AryeIs/DMM_Module/DMM_Module.pdf

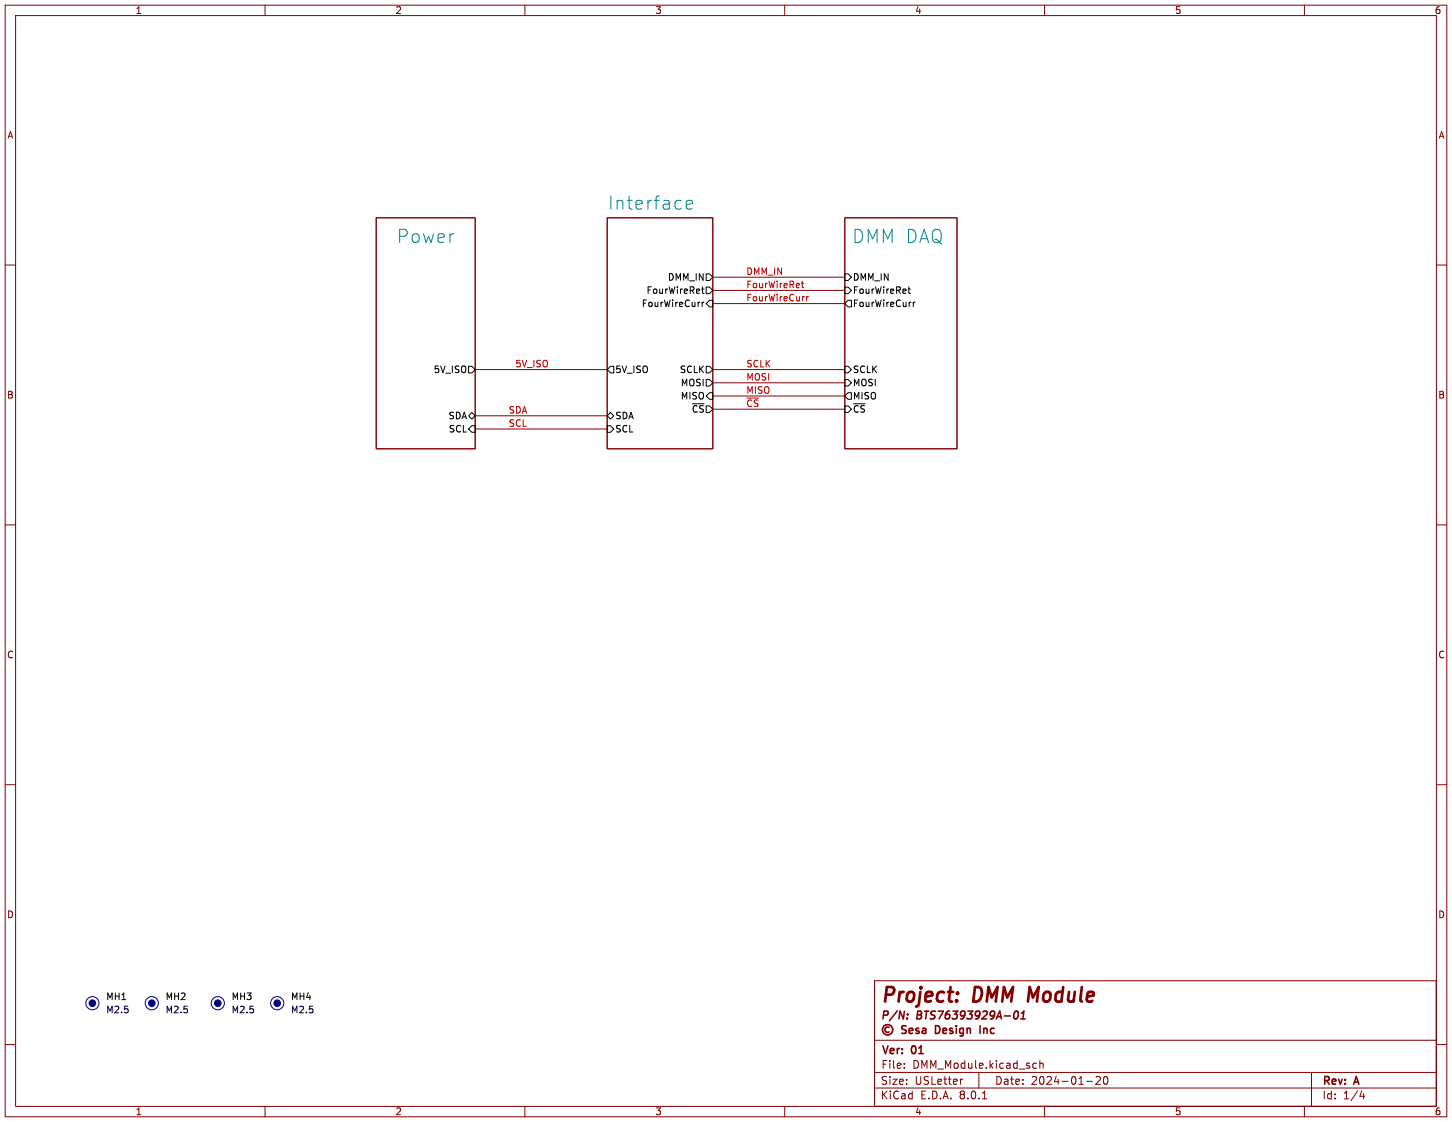
[picture p1: page 1]

SCLK MOSI FourWireRet FourWireCurr DMM_IN DMM DAQ

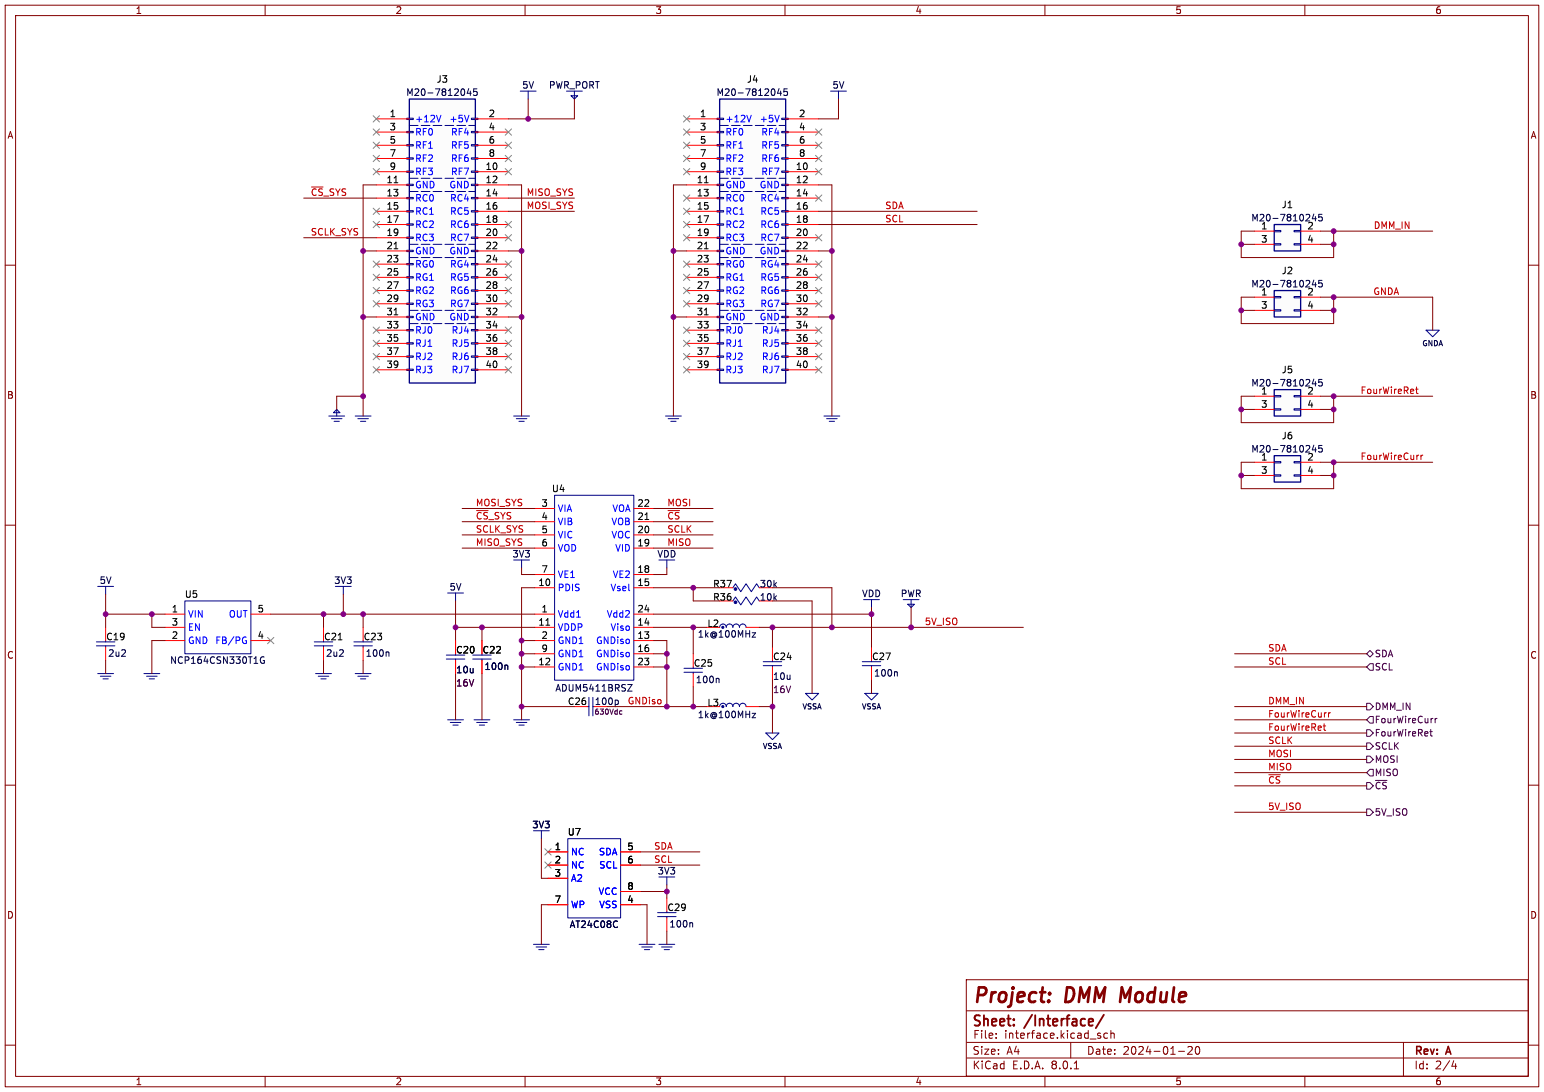
[picture p2: page 2]

~{CS} SDA
FourWireCurr MOSI SCL SCLK

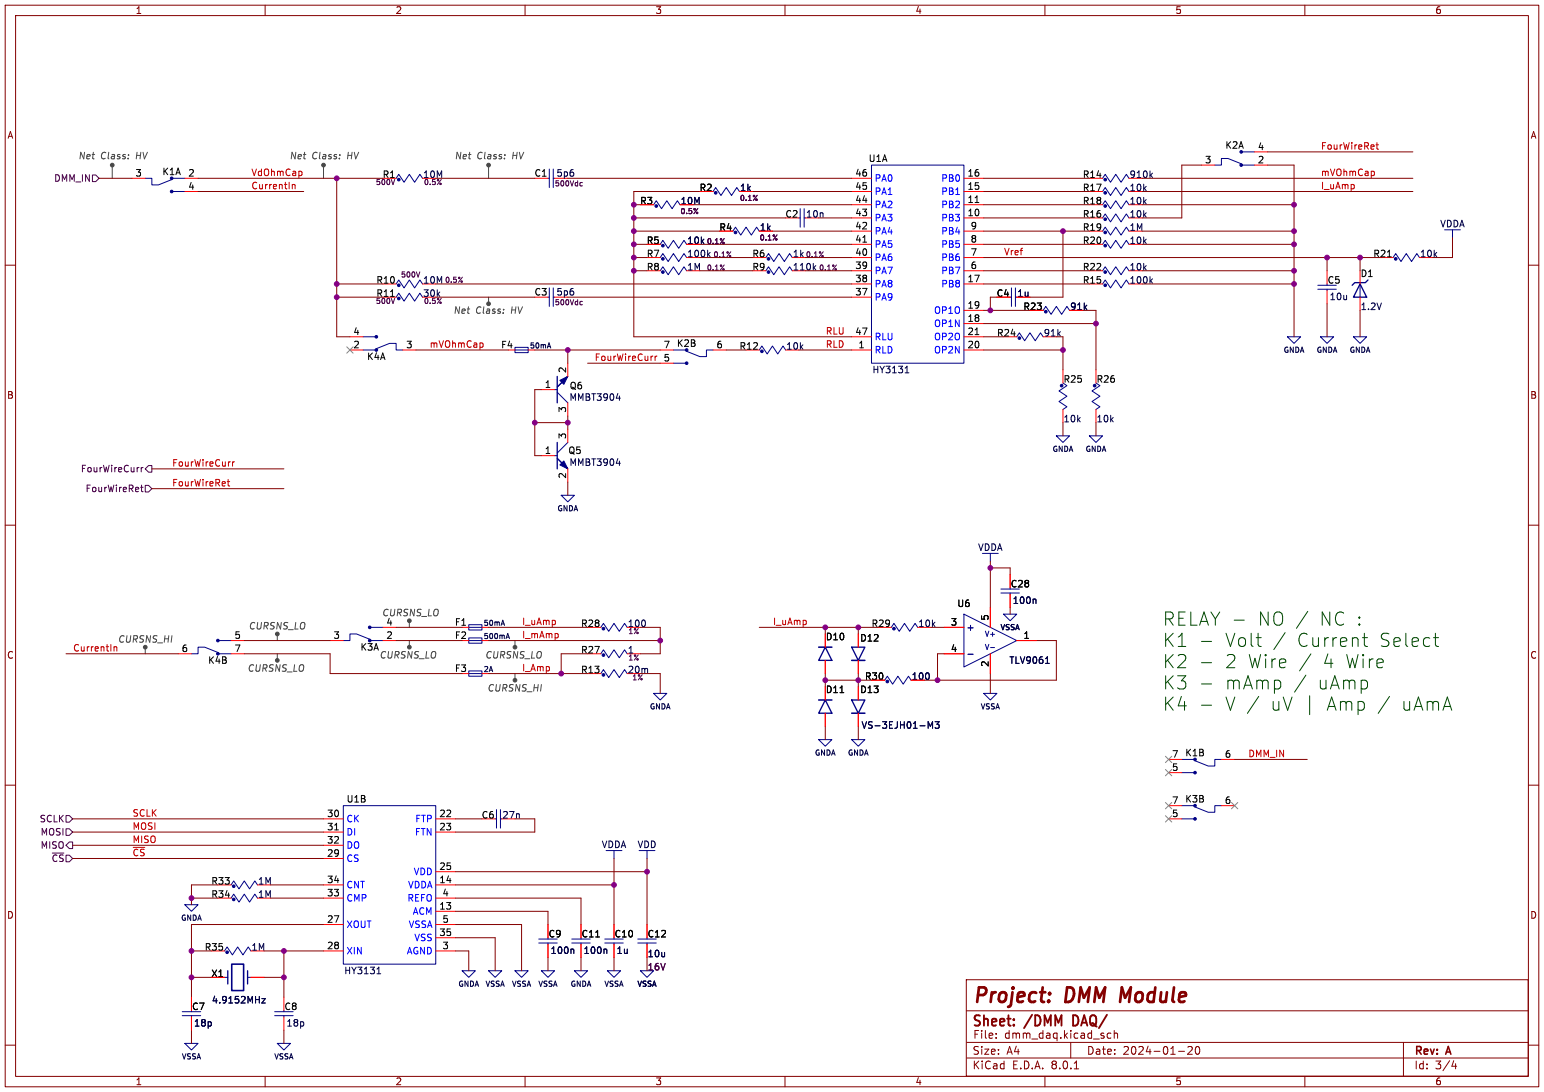
[picture p3: page 3]

Net Class: HV MOSI SCLK

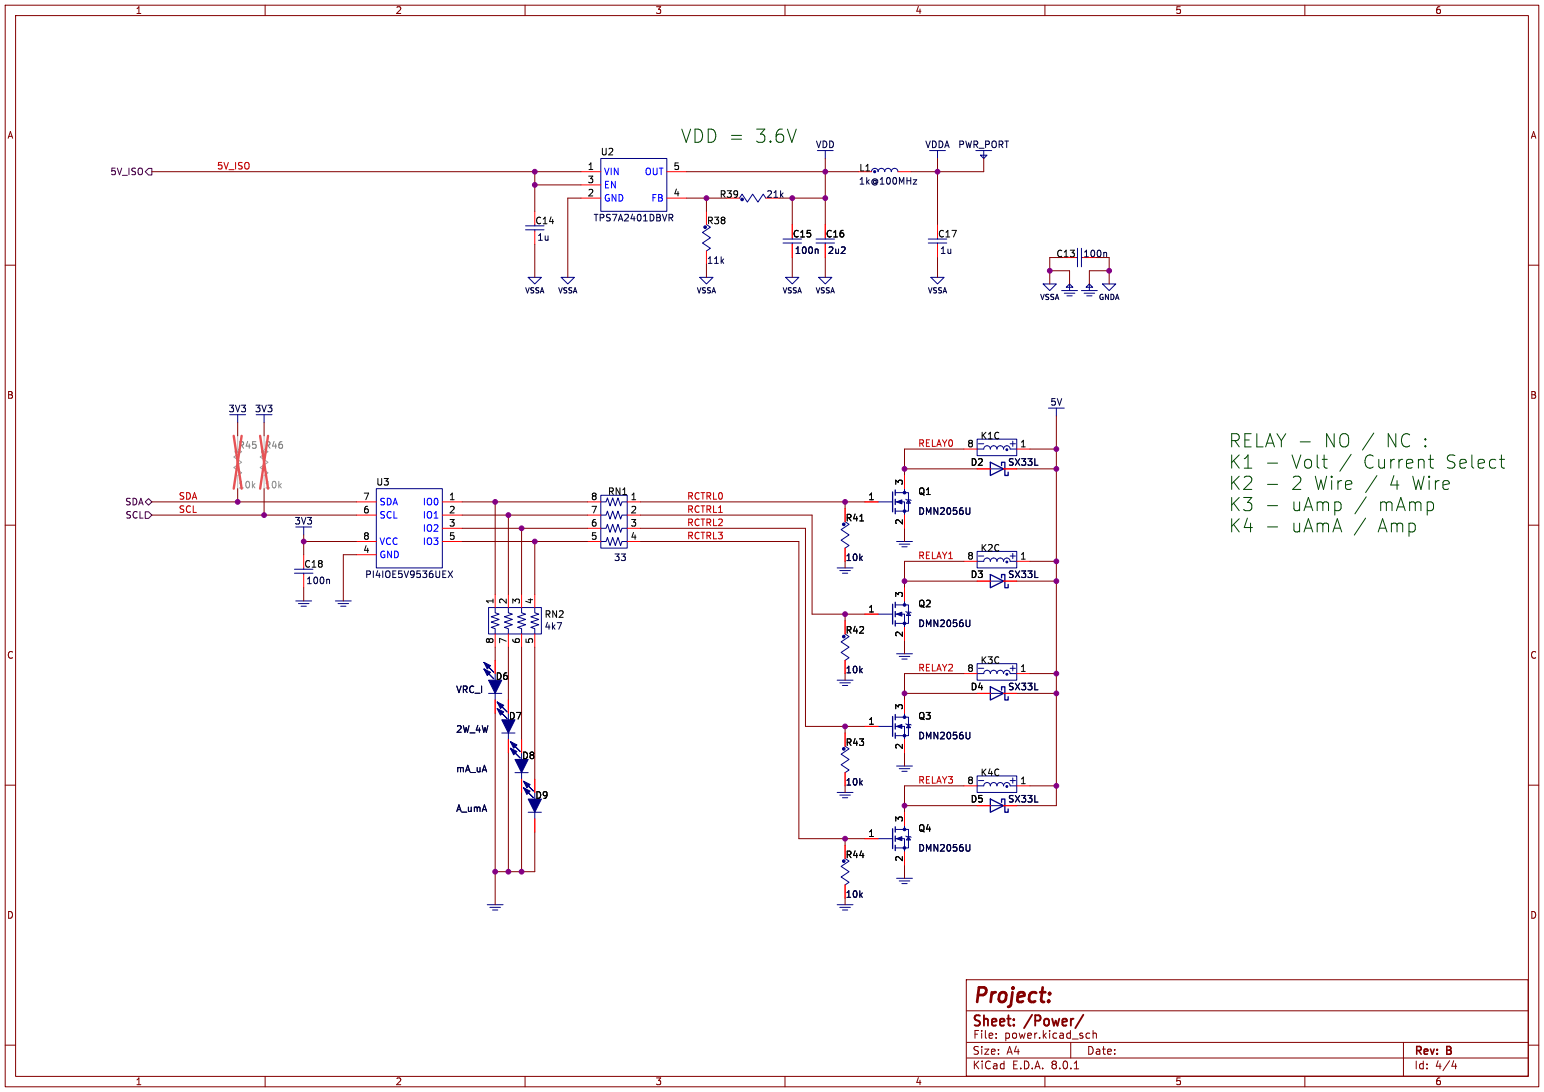
[picture p4: page 4]
