AryeIs/DMM_Module/DMM_Module.kicad_pcb

## KiCad design DMM_Module.kicad_pcb (2024-04-27)

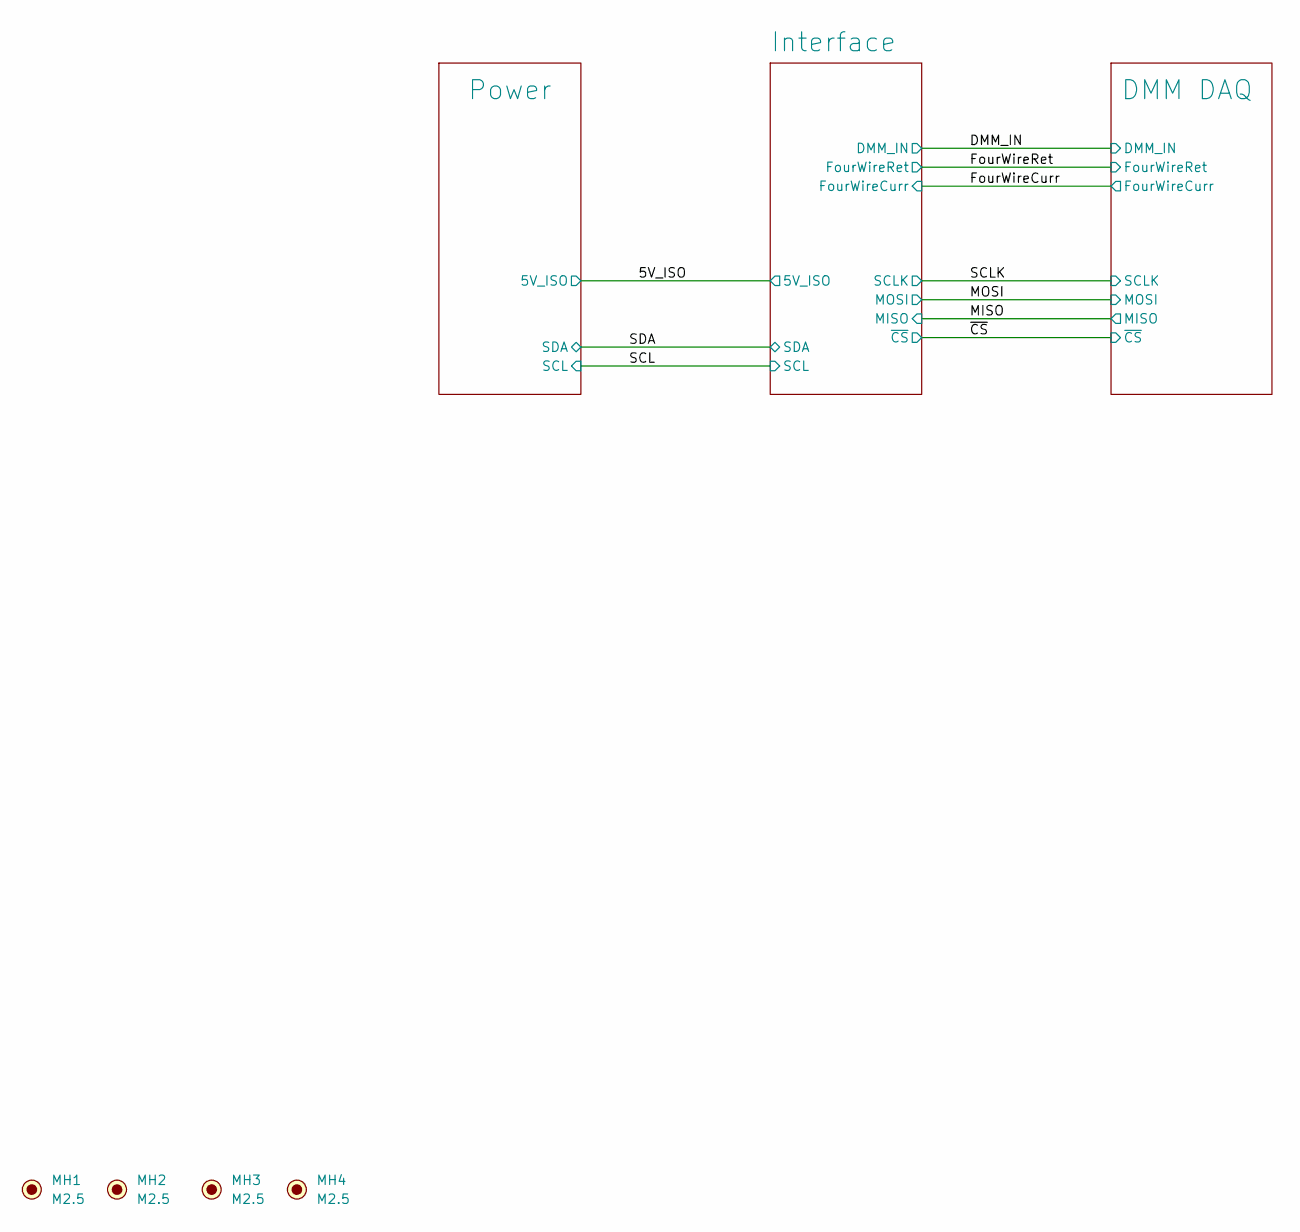
[picture p5: schematic DMM_Module.kicad_sch, ${PART_NAME}]

Parts:
MH1, MH2, MH3, MH4: M2.5; MountingHole_2.7mm_M2.5

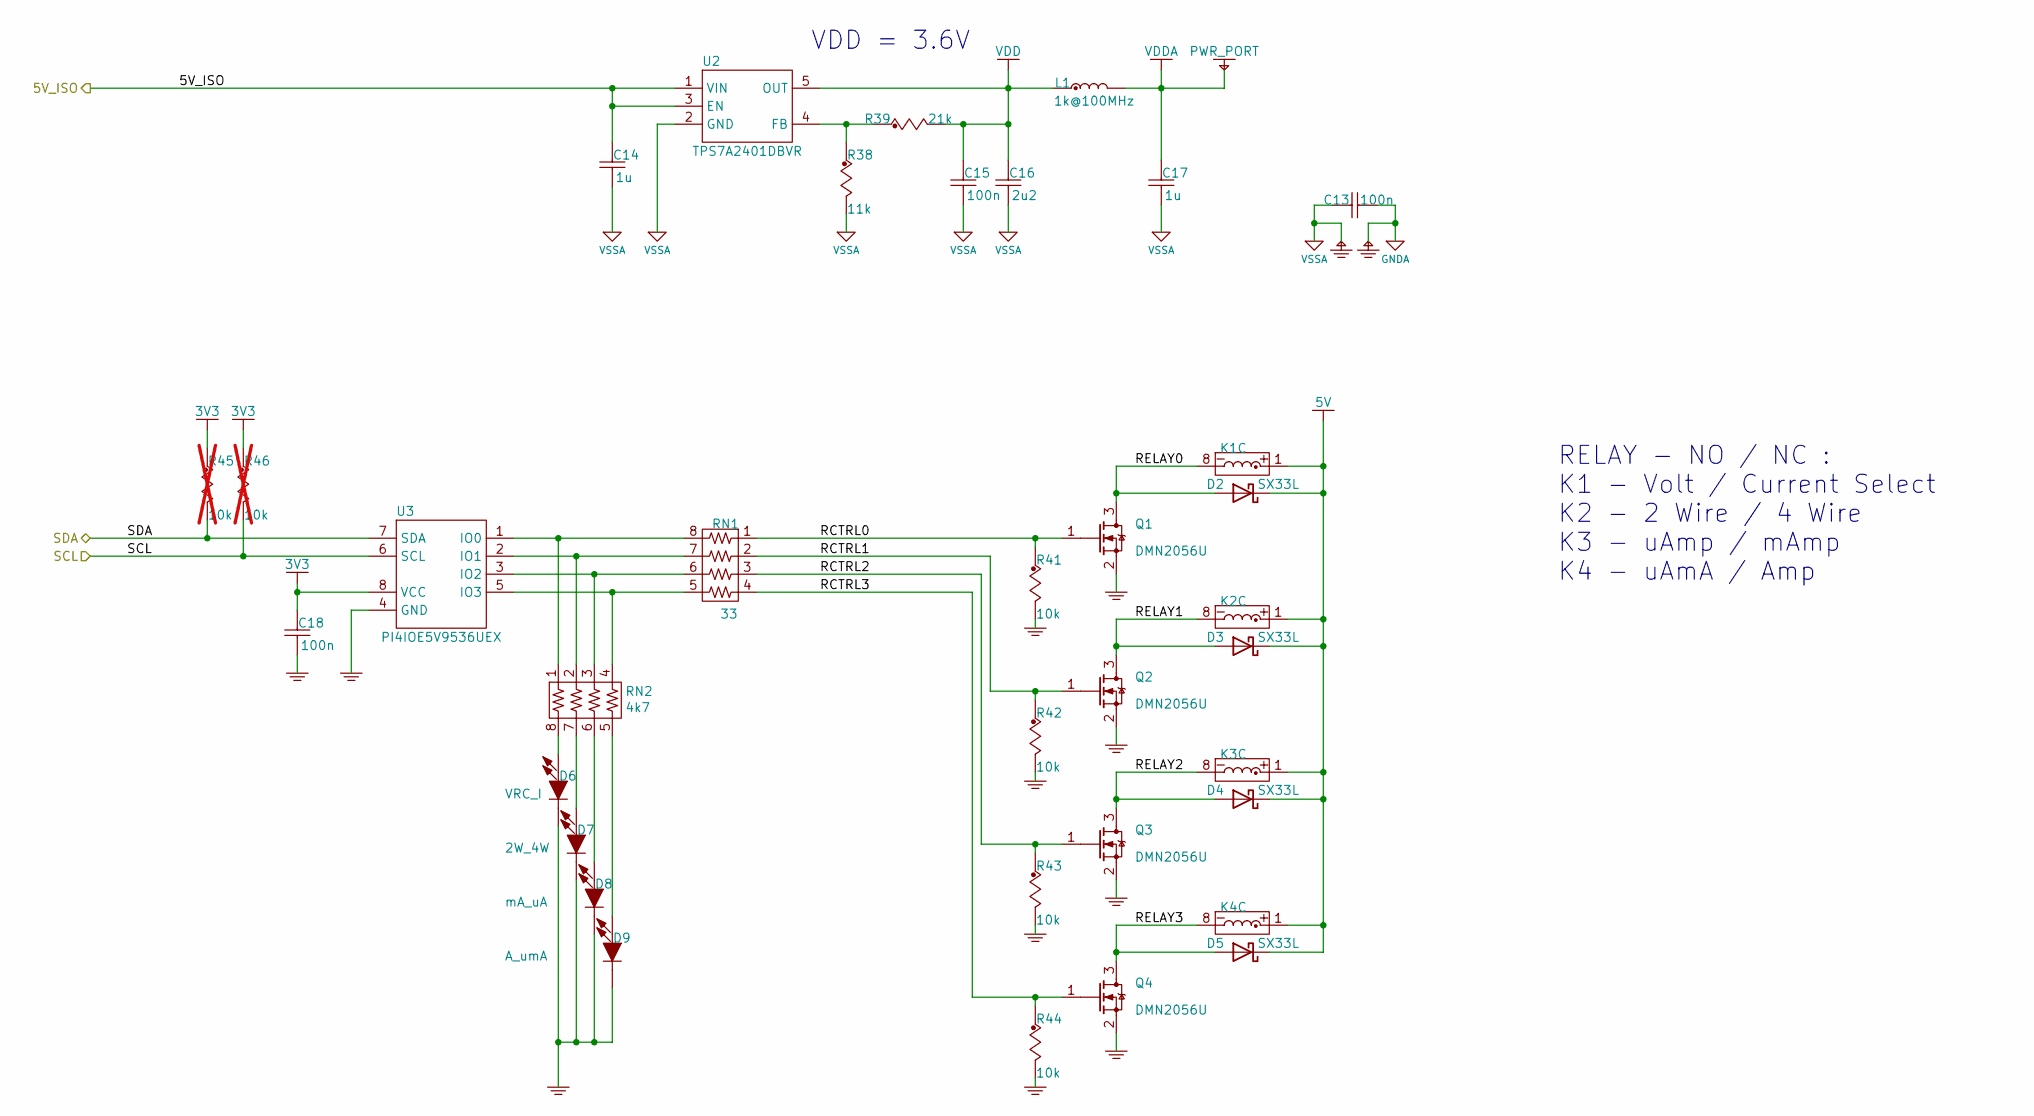
[picture p6: schematic power.kicad_sch]

Parts:
C13, C15, C18: 100n; C_0603_1608Metric; Voltage 50V; MFG PN CL10B104JB8NNNC
C14, C17: 1u; C_0603_1608Metric; Voltage 25V; MFG PN CL10B105KA8NNNC
C16: 2u2; C_0603_1608Metric; Voltage 25V; MFG PN CL10A225KP8NNNC
D2, D3, D4, D5: SX33L; D_SOD-123; MFG PN MBR1020VL_R1_00001
D6: VRC_I; LED_0603_1608Metric; MFG PN 150060GS55040
D7: 2W_4W; LED_0603_1608Metric; MFG PN 150060GS55040
D8: mA_uA; LED_0603_1608Metric; MFG PN 150060GS55040
D9: A_umA; LED_0603_1608Metric; MFG PN 150060GS55040
K1, K2, K3, K4: G6K-2F-Y-TR; DPDT_G6K-2F-Y; Voltage 5VDC; MFG PN G6K-2F-Y-TR DC5
L1: 1k@100MHz; L_0603_1608Metric; MFG PN 74279266
Q1, Q2, Q3, Q4: DMN2056U; SOT-23; MFG PN DMN2056U-7
R38: 11k; R_0603_1608Metric; Tolerance 1%; MFG PN CR0603-FX-1102ELF
R39: 21k; R_0603_1608Metric; Tolerance 1%; MFG PN CR0603-FX-2102ELF
R41, R42, R43, R44: 10k; R_0603_1608Metric; Tolerance 1%; MFG PN CR0603AFX-1002EAS
R45, R46: 10k; R_0603_1608Metric; Tolerance 1%; MFG PN CR0603AFX-1002EAS; not fitted
RN1: 33; R_Array_Convex_4x0603; MFG PN YC164-FR-0733RL
RN2: 4k7; R_Array_Convex_4x0603; MFG PN YC164-FR-074K7L
U2: TPS7A2401DBVR; SOT-23-5; MFG PN TPS7A2401DBVR
U3: PI4IOE5V9536UEX; TSSOP-8_3x3mm_P0.65mm; MFG PN PI4IOE5V9536UEX

Connections:
3V3: C18.2, R45.1, R46.1, U3.8 (VCC); also elsewhere on the board
5V: D2.1 (K), D3.1 (K), D4.1 (K), D5.1 (K), K1.1 (COIL1), K2.1 (COIL1), K3.1 (COIL1), K4.1 (COIL1); also elsewhere on the board
/5V_ISO: C14.2, U2.1 (VIN), U2.3 (EN); also elsewhere on the board
/Power/RCTRL0: Q1.1 (G), R41.1, RN1.1
/Power/RCTRL1: Q2.1 (G), R42.1, RN1.2
/Power/RCTRL2: Q3.1 (G), R43.1, RN1.3
/Power/RCTRL3: Q4.1 (G), R44.1, RN1.4
/Power/RELAY0: D2.2 (A), K1.8 (COIL2), Q1.3 (D)
/Power/RELAY1: D3.2 (A), K2.8 (COIL2), Q2.3 (D)
/Power/RELAY2: D4.2 (A), K3.8 (COIL2), Q3.3 (D)
/Power/RELAY3: D5.2 (A), K4.8 (COIL2), Q4.3 (D)
/SCL: R46.2, U3.6 (SCL); also elsewhere on the board
/SDA: R45.2, U3.7 (SDA); also elsewhere on the board
GND: C18.1, D6.1 (K), D7.1 (K), D8.1 (K), D9.1 (K), Q1.2 (S), Q2.2 (S), Q3.2 (S), Q4.2 (S), R41.2, R42.2, R43.2, R44.2, U3.4 (GND); also elsewhere on the board
unnamed: D6.2 (A), RN2.8
unnamed: D7.2 (A), RN2.7
unnamed: D8.2 (A), RN2.6
unnamed: D9.2 (A), RN2.5
unnamed: R38.1, R39.1, U2.4 (FB)
unnamed: RN1.8, RN2.1, U3.1 (IO0)
unnamed: RN1.7, RN2.2, U3.2 (IO1)
unnamed: RN1.6, RN2.3, U3.3 (IO2)
unnamed: RN1.5, RN2.4, U3.5 (IO3)
VDD: C15.2, C16.2, L1.1, R39.2, U2.5 (OUT); also elsewhere on the board
VDDA: C17.2, L1.2; also elsewhere on the board

Notes on the sheet:
RELAY - NO / NC : K1 - Volt / Current Select K2 - 2 Wire / 4 Wire K3 - uAmp / mAmp K4 - uAmA / Amp
VDD = 3.6V

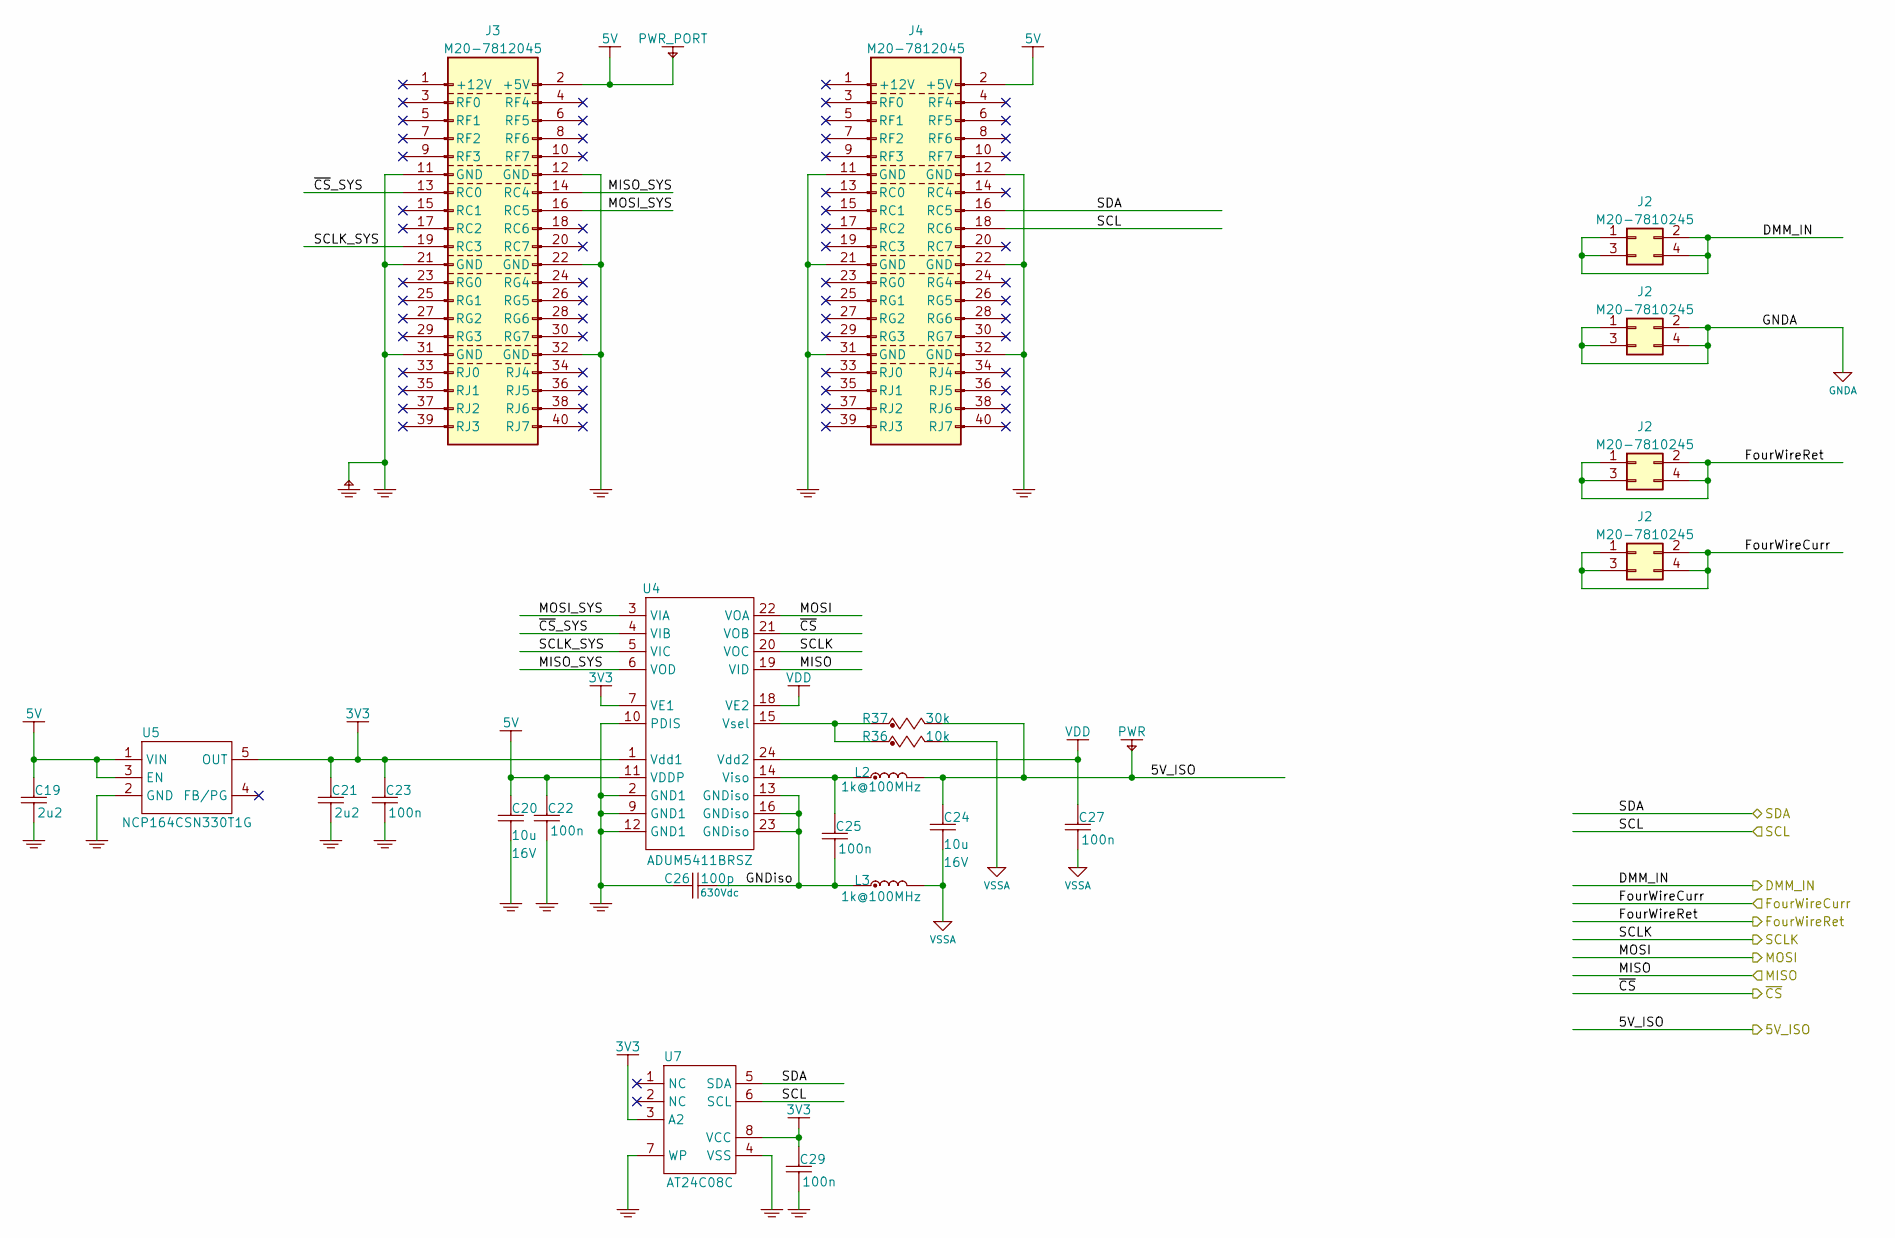
[picture p7: schematic interface.kicad_sch, ${PART_NAME}]

Parts:
C19, C21: 2u2; C_0603_1608Metric; Voltage 25V; MFG PN CL10A225KP8NNNC
C20, C24: 10u; C_0603_1608Metric; Voltage 16V; MFG PN CL10A106KO8NQNC
C22, C23, C25, C27, C29: 100n; C_0603_1608Metric; Voltage 50V; MFG PN CL10B104JB8NNNC
C26: 100p; C_1206_3216Metric; Voltage 630Vdc; Tolerance 5%; MFG PN CC1206JKNPOZBN101
J2: M20-7810245; Header_SKT_02x02_Fixed_Harwin_M20-7810245; Mfg P/N M20-7810245
J3, J4: M20-7812045; Header_SKT_02x20_Fixed_Harwin_M20-7812045; Mfg P/N M20-7812045
L2, L3: 1k@100MHz; L_0603_1608Metric; MFG PN 74279266
R36: 10k; R_0603_1608Metric; Tolerance 1%; MFG PN CR0603AFX-1002EAS
R37: 30k; R_0603_1608Metric; Tolerance 1%; MFG PN CR0603-FX-3002ELF
U4: ADUM5411BRSZ; SSOP-24_5.3x8.2mm_P0.65mm; MFG PN ADUM5411BRSZ-RL7
U5: NCP164CSN330T1G; SOT-23-5; MFG PN NCP164CSN330T1G
U7: AT24C08C; TSSOP-8_4.4x3mm_P0.65mm; MFG PN AT24C08C-XHM-T

Connections:
3V3: C21.2, C23.2, C29.2, U4.1 (Vdd1), U4.7 (VE1), U5.5 (OUT), U7.3 (A2), U7.8 (VCC); also elsewhere on the board
5V: C19.2, C20.2, C22.2, J3.2 (+5V), J4.2 (+5V), U4.11 (VDDP), U5.1 (VIN), U5.3 (EN); also elsewhere on the board
/5V_ISO: C24.2, L2.2, R37.2; also elsewhere on the board
/Interface/GNDiso: C25.1, C26.1, L3.1, U4.13 (GNDiso), U4.16 (GNDiso), U4.23 (GNDiso)
/Interface/MISO_SYS: J3.14 (RC4), U4.6 (VOD)
/Interface/MOSI_SYS: J3.16 (RC5), U4.3 (VIA)
/Interface/SCLK_SYS: J3.19 (RC3), U4.5 (VIC)
/Interface/~CS_SYS: J3.13 (RC0), U4.4 (VIB)
/MISO: U4.19 (VID); also elsewhere on the board
/MOSI: U4.22 (VOA); also elsewhere on the board
/SCL: J4.18 (RC6), U7.6 (SCL); also elsewhere on the board
/SCLK: U4.20 (VOC); also elsewhere on the board
/SDA: J4.16 (RC5), U7.5 (SDA); also elsewhere on the board
/~CS: U4.21 (VOB); also elsewhere on the board
GND: C19.1, C20.1, C21.1, C22.1, C23.1, C26.2, C29.1, J3.11 (GND), J3.12 (GND), J3.21 (GND), J3.22 (GND), J3.31 (GND), J3.32 (GND), J4.11 (GND), J4.12 (GND), J4.21 (GND), J4.22 (GND), J4.31 (GND), J4.32 (GND), U4.2 (GND1), U4.9 (GND1), U4.10 (PDIS), U4.12 (GND1), U5.2 (GND), U7.4 (VSS), U7.7 (WP); also elsewhere on the board
unnamed: C25.2, L2.1, U4.14 (Viso)
unnamed: R36.1, R37.1, U4.15 (Vsel)
VDD: C27.2, U4.18 (VE2), U4.24 (Vdd2); also elsewhere on the board

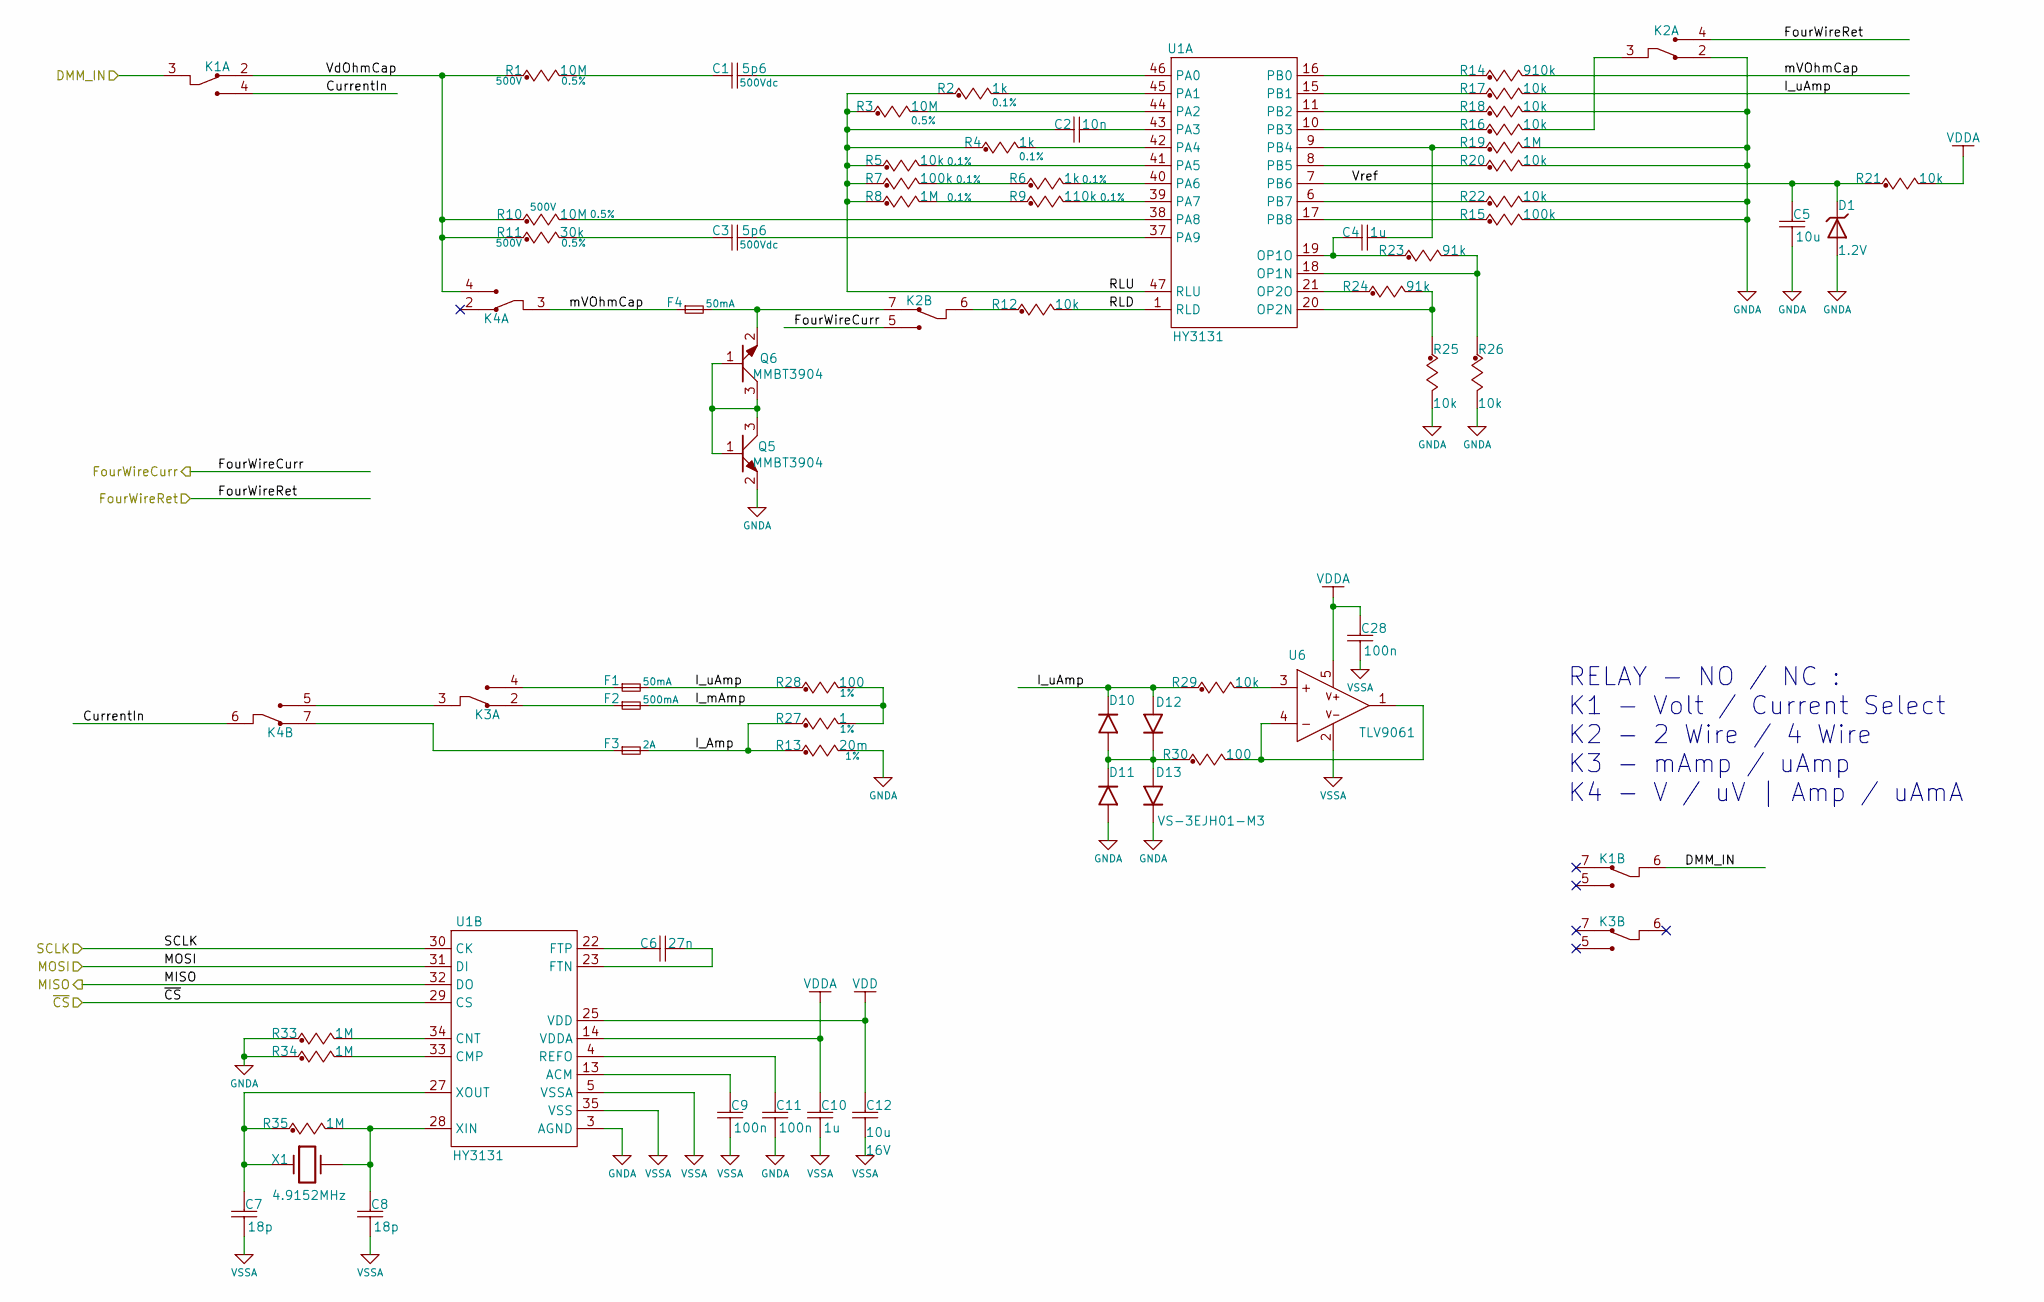
[picture p8: schematic dmm_daq.kicad_sch, ${PART_NAME}]

Parts:
C1, C3: 5p6; C_1206_3216Metric; Voltage 500Vdc; Tolerance 5%; MFG PN CC1206CRNPOBBN5R6
C2: 10n; C_0603_1608Metric; Voltage 50V; MFG PN CL10B103KB8NNNC
C4, C10: 1u; C_0603_1608Metric; Voltage 25V; MFG PN CL10B105KA8NNNC
C5: 10u; C_0603_1608Metric; Voltage 10V; MFG PN CL10A106KP8NNWC
C6: 27n; C_0603_1608Metric; Voltage 50V; MFG PN CC0603JRX7R9BB273
C7, C8: 18p; C_0603_1608Metric; Voltage 50V; MFG PN CL10C180JB81PNC
C9, C11, C28: 100n; C_0603_1608Metric; Voltage 50V; MFG PN CL10B104JB8NNNC
C12: 10u; C_0603_1608Metric; Voltage 16V; MFG PN CL10A106KO8NQNC
D1: 1.2V; SOT-23; MFG PN LM385M3X-1.2/NOPB
D10, D11, D12, D13: VS-3EJH01-M3; SlimSMPA; MFG PN VS-3EJH01-M3/6B
F1, F4: 50mA; Fuse_1206_3216Metric; MFG PN 0ZCJ0005FF2E
F2: 500mA; Fuse_1206_3216Metric; MFG PN 0ZCJ0050AF2E
F3: 2A; Fuse_1206_3216Metric; MFG PN 0ZCJ0200FF2C
K1, K2, K3, K4: G6K-2F-Y-TR; DPDT_G6K-2F-Y; Voltage 5VDC; MFG PN G6K-2F-Y-TR DC5
Q5, Q6: MMBT3904; SOT-23-3; MFG PN MMBT3904
R1, R10: 10M; R_1206_3216Metric; Tolerance 0.5%; Voltage 500V; MFG PN ERJ-P08D1004V
R2, R4, R6: 1k; R_0603_1608Metric; Tolerance 0.1%; MFG PN ERJ-PB3B1001V
R3: 10M; R_0603_1608Metric; Tolerance 0.5%; MFG PN CRCW060310M0DHEAP
R5: 10k; R_0603_1608Metric; Tolerance 0.1%; MFG PN ERA-3VEB1002V
R7: 100k; R_0603_1608Metric; Tolerance 0.1%; MFG PN ERA-3VEB1003V
R8, R19, R33, R34, R35: 1M; R_0603_1608Metric; Tolerance 0.1%; MFG PN RT0603BRD071ML
R9: 110k; R_0603_1608Metric; Tolerance 0.1%; MFG PN ERA-3AEB114V
R11: 30k; R_1206_3216Metric; Tolerance 0.5%; Voltage 500V; MFG PN ERJ-P08D3002V
R12, R16, R17, R18, R20, R21, R22, R25, R26, R29: 10k; R_0603_1608Metric; Tolerance 1%; MFG PN CR0603AFX-1002EAS
R13: 20m; R_1206_3216Metric; Tolerance 1%; MFG PN ERJ-8CWFR020V
R14: 910k; R_0603_1608Metric; Tolerance 1%; MFG PN CRCW0603910KFKEA
R15: 100k; R_0603_1608Metric; Tolerance 1%; MFG PN CR0603-FX-1003ELF
R23, R24: 91k; R_0603_1608Metric; Tolerance 1%; MFG PN CR0603-FX-9102ELF
R27: 1; R_1206_3216Metric; Tolerance 1%; MFG PN ERJ-8BQF1R0V
R28: 100; R_1206_3216Metric; Tolerance 1%; MFG PN RT1206FRD07100RL
R30: 100; R_0603_1608Metric; Tolerance 1%; MFG PN CR0603-FX-1000ELF
U1: HY3131; LQFP-48_7x7mm_P0.5mm; MFG PN HY3131-L048
U6: TLV9061; SOT-23-5; MFG PN TLV9061QDBVRQ1
X1: 4.9152MHz; Crystal_SMD_HC49-SD; MFG PN ABLS-4.9152MHZ-B4-T

Connections:
/DMM DAQ/CurrentIn: K1.4 (NO1), K4.6 (COM2)
/DMM DAQ/I_Amp: F3.2, R13.1, R27.1
/DMM DAQ/I_mAmp: F2.2, R27.2, R28.2
/DMM DAQ/I_uAmp: D10.1 (K), D12.2 (A), F1.2, R17.2, R28.1, R29.1
/DMM DAQ/RLD: R12.2, U1.1 (RLD)
/DMM DAQ/RLU: C2.2, R2.1, R3.1, R4.1, R5.1, R7.1, R8.1, U1.47 (RLU)
/DMM DAQ/VdOhmCap: K1.2 (NC1), K4.4 (NO1), R1.1, R10.1, R11.1
/DMM DAQ/Vref: C5.2, D1.1 (K), R21.1, U1.7 (PB6)
/DMM DAQ/mVOhmCap: F4.1, K4.3 (COM1), R14.2
/DMM_IN: K1.3 (COM1), K1.6 (COM2); also elsewhere on the board
/FourWireCurr: K2.5 (NO2); also elsewhere on the board
/FourWireRet: K2.4 (NO1); also elsewhere on the board
/MISO: U1.32 (DO); also elsewhere on the board
/MOSI: U1.31 (DI); also elsewhere on the board
/SCLK: U1.30 (CK); also elsewhere on the board
/~CS: U1.29 (CS); also elsewhere on the board
unnamed: C1.2, R1.2
unnamed: C3.2, R11.2
unnamed: D10.2 (A), D11.1 (K), D12.1 (K), D13.2 (A), R30.1
unnamed: K2.3 (COM1), R16.2
unnamed: K2.6 (COM2), R12.1
unnamed: F4.2, K2.7 (NC2), Q6.2 (S)
unnamed: K3.3 (COM1), K4.5 (NO2)
unnamed: F2.1, K3.2 (NC1)
unnamed: F1.1, K3.4 (NO1)
unnamed: F3.1, K4.7 (NC2)
unnamed: Q5.1 (G), Q5.3 (D), Q6.1 (G), Q6.3 (D)
unnamed: R6.1, R7.2
unnamed: R8.2, R9.1
unnamed: R23.2, R26.1, U1.18 (OP1N)
unnamed: C4.2, R23.1, U1.19 (OP1O)
unnamed: R24.2, R25.1, U1.20 (OP2N)
unnamed: R24.1, U1.21 (OP2O)
unnamed: C1.1, U1.46 (PA0)
unnamed: R2.2, U1.45 (PA1)
unnamed: R3.2, U1.44 (PA2)
unnamed: C2.1, U1.43 (PA3)
unnamed: R4.2, U1.42 (PA4)
unnamed: R5.2, U1.41 (PA5)
unnamed: R6.2, U1.40 (PA6)
unnamed: R9.2, U1.39 (PA7)
unnamed: R10.2, U1.38 (PA8)
unnamed: C3.1, U1.37 (PA9)
unnamed: R14.1, U1.16 (PB0)
unnamed: R17.1, U1.15 (PB1)
unnamed: R18.1, U1.11 (PB2)
unnamed: R16.1, U1.10 (PB3)
unnamed: C4.1, R19.1, U1.9 (PB4)
unnamed: R20.1, U1.8 (PB5)
unnamed: R22.1, U1.6 (PB7)
unnamed: R15.1, U1.17 (PB8)
unnamed: C9.2, U1.13 (ACM)
unnamed: R34.2, U1.33 (CMP)
unnamed: R33.2, U1.34 (CNT)
unnamed: C6.1, U1.23 (FTN)
unnamed: C6.2, U1.22 (FTP)
unnamed: C11.2, U1.4 (REFO)
unnamed: C8.2, R35.2, U1.28 (XIN), X1.2
unnamed: C7.2, R35.1, U1.27 (XOUT), X1.1
unnamed: R29.2, U6.3 (IN+)
unnamed: R30.2, U6.1 (OUTA), U6.4 (IN-)
VDD: C12.2, U1.25 (VDD); also elsewhere on the board
VDDA: C10.2, C28.2, R21.2, U1.14 (VDDA), U6.5 (V+); also elsewhere on the board

Notes on the sheet:
RELAY - NO / NC : K1 - Volt / Current Select K2 - 2 Wire / 4 Wire K3 - mAmp / uAmp K4 - V / uV | Amp / uAmA

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
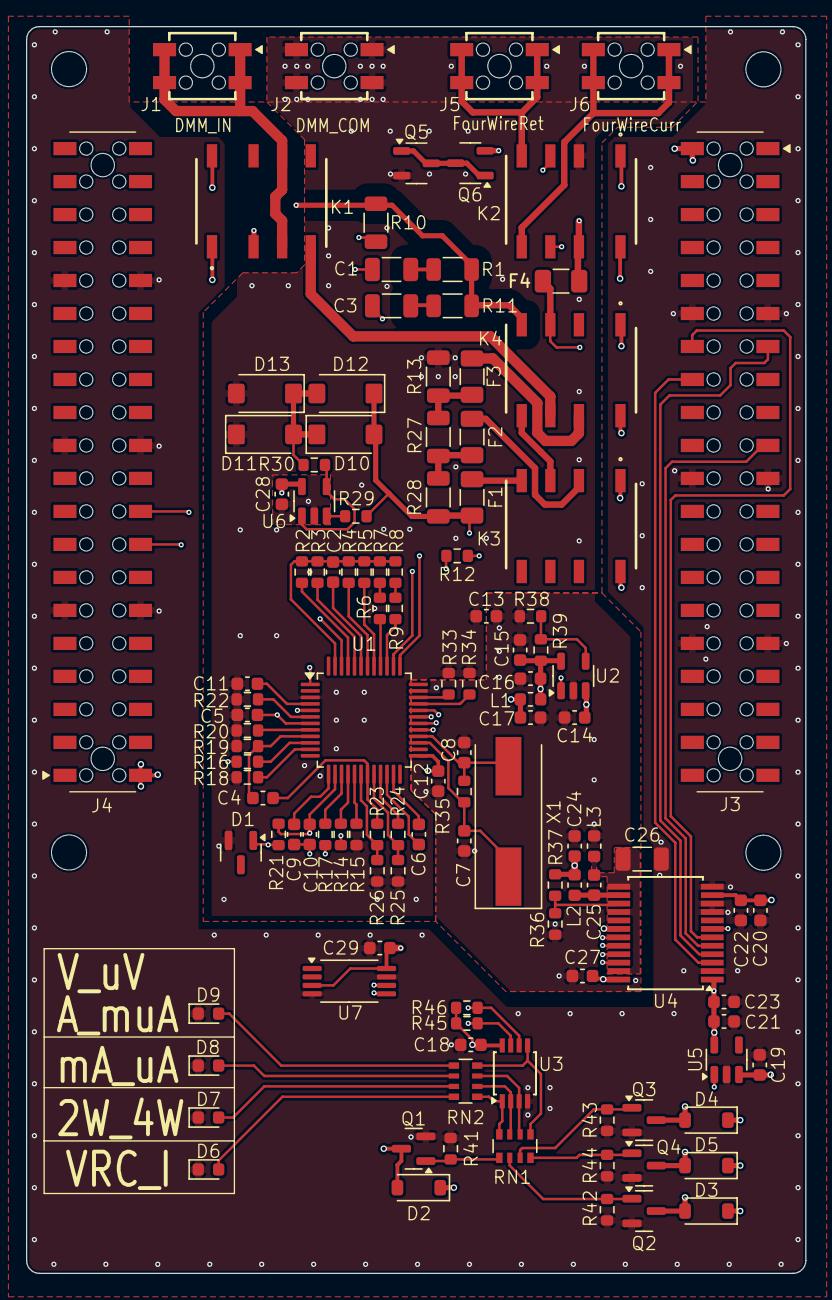
[picture p9: board DMM_Module.kicad_pcb from above]

Board: 4 copper layers, 60.0 x 96.0 mm, 122 parts (0 on the bottom side), 95 nets.

Other parts of the board:
J1, J5, J6: M20-7810245; Header_SKT_02x02_Fixed_Harwin_M20-7810245

Their connections:
/DMM_IN: J1.1, J1.2, J1.3, J1.4; also elsewhere on the board
/FourWireCurr: J6.1, J6.2, J6.3, J6.4; also elsewhere on the board
/FourWireRet: J5.1, J5.2, J5.3, J5.4; also elsewhere on the board
