AryeIs/DMM_Module/(commit log)

2024-02-04 preliminary placement
    [DMM_Module.kicad_pcb, DMM_Module.kicad_sch, dmm_daq.kicad_sch, interface.kicad_sch, power.kicad_sch]
2024-02-18 Board is fully routed
    [DMM_Module.kicad_pcb, dmm_daq.kicad_sch, interface.kicad_sch, power.kicad_sch]
2024-02-20 Step and gerber files added
    [DMM_Module.kicad_pcb, dmm_daq.kicad_sch]
2024-02-20 Drills added
2024-02-20 Drills added, gitignore updated
2024-04-19 Added galvanic isolation
    [DMM_Module.kicad_pcb, DMM_Module.kicad_sch, dmm_daq.kicad_sch, interface.kicad_sch, power.kicad_sch]
2024-04-19 Board thickness adjusted
    [DMM_Module.kicad_pcb]
2024-04-22 Schematics updated with current protection and EEPROM
    [DMM_Module.kicad_pcb, DMM_Module.kicad_sch, dmm_daq.kicad_sch, interface.kicad_sch, power.kicad_sch]
2024-04-25 Isolated analog path is fully routed
    [DMM_Module.kicad_pcb, dmm_daq.kicad_sch, power.kicad_sch]
2024-04-26 Added GND vias for high current path
    [DMM_Module.kicad_pcb]
2024-04-26 Relay traces were aligned
    [DMM_Module.kicad_pcb]
2024-04-26 Gerber archive updated
2024-04-27 U1 pad thickness was reduced to 0.28 to comply with the manufacturer's constraints
    [DMM_Module.kicad_pcb]
2024-06-17 10MOhm resistors partnumber updated
    [DMM_Module.kicad_sch, dmm_daq.kicad_sch, interface.kicad_sch, power.kicad_sch]
